Edragon/MCU-AVR-ATSAM/SAM-D10-Xplain-Mini_Design-Documentation/PCBA_rev2/BOM/Bill of Materials Print- SAM_D10_Xplained_Mini_release_rev2.xls

Sheet: Part List Report
 | Component list |  | ATSAMD10-XMINI
 | Source Data From: |  | ATSAMD10-XMINI.PrjPCB
 | Project: |  | ATSAMD10-XMINI.PrjPCB
 | Variant: |  | Default_assembly
 | Report Date: | 11/19/2014 | 3:48:48 PM
 | Print Date: | 11/19/2014 | 3:48:09 PM
# | Designator | Quantity | Value | Manufacturer | MPN | Description
1 | C101, C102, C104, C107, C108, C200, C201, C204, C205 | 9 | 100n | Kemet | C0402C104K4RACTU | Ceramic capacitor, SMD 0402, X7R, 16V, +/-10%
2 | C103 | 1 | 1u | Kemet | C0402C105K9PAC | Ceramic capacitor, SMD 0402, X5R, 6.3V, +/-10% (de26942)
3 | C105, C106 | 2 | 12pF | Kyocera-elco | CM05CG120J50AH | Ceramic capacitor, SMD 0402, NP0, 50V, +/-5% (de19819)
4 | C300, C302 | 2 | 4.7uF | AVX | 0603ZD475KAT2A | Ceramic capacitor, SMD 0603, X5R, 10V, ±10 %
5 | C301 | 1 | 10n |  |  | Ceramic capacitor, SMD 0402, X7R, 25V, +/-10%
6 | D100 | 1 | EL17-21SYGC | Everlight | EL17-21SYGC | LED, Green, Wave length=575nm, SMD 0805, ±70°
7 | D200 | 1 | EL17-21UYC/A3 | Everlight | 17-21UYC/S530-A3/TR8 | LED, Yellow, Wave length=591nm, SMD 0805, ±70°
8 | F100 | 1 | MC36213 | Multicomp | MC36213 | Resetable PTC fuse, Ih = 0.5A, It = 1.0A, 0805 package
9 | FW1 | 1 | MEDBG firmware |  |  | MEDBG firmware
10 | J101 | 1 | ZX62D-B-5PA8 | HIROSE | ZX62D-B-5PA8 | Micro USB B Connector, Standard SMT + DIP
11 | LABEL1 | 1 | PCBA Label | ACT Logimark AS | 505462 | PCBA identification label PP Top White Gloss
12 | PCB1 | 1 | ATSAMD10-XMINI PCB |  |  | ATSAMD10-XMINI PCB documantation
13 | PCBADOC1 | 1 | ATSAMD10-XMINI PCBA DOC |  |  | ATSAMD10-XMINI PCBA documantation
14 | Q101 | 1 | IRLML6402PBF | International Rectifier | IRLML6402PBF | P-ch. MOSFET. -30V, -3.7A continuous,RDS(ON)=0.05Ohm@VGS=-4,5V, RDS(ON)=0.08Ohm@VGS=-2.5V
15 | Q102 | 1 | 2N7002,215 | NXP | 2N7002,215 | N-Channel MOSFET. 60V, 0.300A continuous, 1.2A Peak. RDS(ON) = 3.8Ohm@VGS=4.5V, VGS(th)<2.5V
16 | R101, R102 | 2 | 22R | Samsung | RC100SF22R0CS | Thick film resistor, SMD 0402, 1/16W, 1% (de23607)
17 | R103 | 1 | 3.3k |  |  | Thick film resistor, SMD 0402, 1/16W, 1%
18 | R104, R105, R117, R118, R201, R203 | 6 | 100k |  |  | Thick film resistor, SMD 0402, 1/16W, 1%
19 | R107, R108, R202 | 3 | 1k |  |  | Thick film resistor, SMD 0402, 1/16W, 1%
20 | R109, R111, R112 | 3 | 330R |  |  | Thick film resistor, SMD 0402, 1/16W, 1%
21 | R110, R300, R302 | 3 | 0R | (n/a) | RMCF0402ZT0R00 | RES 0.0 OHM 1/16W 0402 SMD
22 | R114 | 1 | 680R |  |  | Thick film resistor, SMD 0402, 1/16W, 1%
23 | SW200 | 1 | SKRAAKE010 | ALPS | SKRAAKE010 | 6.2x6.2 mm SMD tact switch, same as A08-0091 but less force is needed
24 | TEST2 | 1 | Test SW for for A09-2376 |  |  | Test SW for for A09-2376, ATSAMD10-XMINI
25 | TESTDOC1 | 1 | ATmega168-XMINI Test Instructions |  |  | Fixture Test Instructions for ATmega168-XMINI
26 | U100 | 1 | ATmega32U4-MU | ATMEL | ATmega32U4-MU | ATmega32U4 QFN package
27 | U200 | 1 | ATSAMD10D14A-MUT | ATMEL | ATSAMD10D14A-MUT | Atmel 32-bit RISC MCU
28 | U300 | 1 | LP2985-33DBV | Texas Instruments | LP2985-33DBV | LDO 3.3V 150mA SOT23-5 1.5% (cer. cap)
29 | XC100 | 1 | 16.0MHz | Epson Toyocom | TSX-3225 16.0000MF09Z-AC3 | 16MHz uXtal, 3.2 x 2.5 mm SMD, CL=9pF, 15PPM, ESR=80ohm(Max.
 |  | 51
Approved |  |  | Notes

Sheet: Project Information
Project Full Path | D:\Tools Team\Xplained_Mini\SAMD10\18-Nov-2014\ATSAMD10-XMINI.PrjPCB
Project Filename | ATSAMD10-XMINI.PrjPCB
Variant Name | Default_assembly
Data-Source Filename | ATSAMD10-XMINI.PrjPCB
Data-Source Full Path | D:\Tools Team\Xplained_Mini\SAMD10\18-Nov-2014\ATSAMD10-XMINI.PrjPCB
Title | ATSAMD10-XMINI
Total Quantity | 51
Report Time | 3:48:48 PM
Report Date | 11/19/2014
Report Date & Tine | 11/19/2014 3:48:48 PM
Output Name | Bill of Materials Print
Output Type | BOM_PartType
Output Generator Name | BOM
Output Generator Description | Bill of Materials
