Edragon/MCU-AVR-ATSAM/SAM-D10-Xplain-Mini_Design-Documentation/PCBA_rev2/Test Points/Assembly Testpoint Report for SAM_D10_Xplained_Mini_release_rev2.txt

Net         Name        X Coord     Y Coord     Side        Hole Size   Type        
PA02        J203-1          6.35mm   20.3286mm  Bottom             1mm  Through hole
PA03        J203-2          6.35mm   17.7886mm  Bottom             1mm  Through hole
PA05        J203-4          6.35mm   12.7086mm  Bottom             1mm  Through hole
PA04        J203-3          6.35mm   15.2486mm  Bottom             1mm  Through hole
PA07        J203-6          6.35mm    7.6286mm  Bottom             1mm  Through hole
PA06        J203-5          6.35mm   10.1686mm  Bottom             1mm  Through hole
PA11        J201-1         54.61mm    7.6286mm  Bottom             1mm  Through hole
PA10        J201-2         54.61mm   10.1686mm  Bottom             1mm  Through hole
PA17        J201-4         54.61mm   15.2486mm  Bottom             1mm  Through hole
PA16        J201-3         54.61mm   12.7086mm  Bottom             1mm  Through hole
PA30        J201-7         54.61mm   22.8686mm  Bottom             1mm  Through hole
PA31        J201-8         54.61mm   25.4086mm  Bottom             1mm  Through hole
PA25        J201-6         54.61mm   20.3286mm  Bottom             1mm  Through hole
PA27        J201-5         54.61mm   17.7886mm  Bottom             1mm  Through hole
PA24        J200-5         54.61mm   39.6326mm  Bottom             1mm  Through hole
PA09        J200-6         54.61mm   42.1726mm  Bottom             1mm  Through hole
PA03        J200-8         54.61mm   47.2526mm  Bottom             1mm  Through hole
PA23        J200-3         54.61mm   34.5526mm  Bottom             1mm  Through hole
PA22        J200-4         54.61mm   37.0926mm  Bottom             1mm  Through hole
NetJ200_2   J200-2         54.61mm   32.0126mm  Bottom             1mm  Through hole
NetJ200_1   J200-1         54.61mm   29.4726mm  Bottom             1mm  Through hole
PA14        J200-9         54.61mm   49.7926mm  Bottom             1mm  Through hole
PA15        J200-10        54.61mm   52.3326mm  Bottom             1mm  Through hole
PD3_UART_TXD1J104-1         16.51mm   48.2686mm  Bottom             1mm  Through hole
PD2_UART_RXD1J104-2         16.51mm   50.8086mm  Bottom             1mm  Through hole
TDI         J100-9          50.8mm   56.5236mm  Bottom          0.65mm  Through hole
VCC_BOARD   J100-4         46.99mm   57.7936mm  Bottom          0.65mm  Through hole
S\R\S\T\    J100-6         48.26mm   57.7936mm  Bottom          0.65mm  Through hole
NetJ100_8   J100-8         49.53mm   57.7936mm  Bottom          0.65mm  Through hole
NetJ100_7   J100-7         49.53mm   56.5236mm  Bottom          0.65mm  Through hole
TMS         J100-5         48.26mm   56.5236mm  Bottom          0.65mm  Through hole
TDO         J100-3         46.99mm   56.5236mm  Bottom          0.65mm  Through hole
TCK         J100-1         45.72mm   56.5236mm  Bottom          0.65mm  Through hole
VCC_TARGET  J204-2         34.24mm    4.9486mm  Bottom             1mm  Through hole
PA22        J204-4          31.7mm    4.9486mm  Bottom             1mm  Through hole
PA24        J204-1         34.24mm    7.4886mm  Bottom             1mm  Through hole
PA09        J204-3          31.7mm    7.4886mm  Bottom             1mm  Through hole
PA28        J204-5         29.16mm    7.4886mm  Bottom             1mm  Through hole
NetJ202_1   J202-1          6.35mm   43.1886mm  Bottom             1mm  Through hole
VCC_TARGET  J202-2          6.35mm   40.6486mm  Bottom             1mm  Through hole
VCC_P3V3    J202-4          6.35mm   35.5686mm  Bottom             1mm  Through hole
RESET_SENSE J202-3          6.35mm   38.1086mm  Bottom             1mm  Through hole
GND         J202-7          6.35mm   27.9486mm  Bottom             1mm  Through hole
VCC_VIN     J202-8          6.35mm   25.4086mm  Bottom             1mm  Through hole
VCC_P5V0    Free-0          3.81mm   33.0286mm  Bottom             1mm  Through hole
            Free-5         16.51mm   25.4086mm  Bottom             1mm  Through hole
            Free-5         16.51mm   22.8686mm  Bottom             1mm  Through hole
GND         Via            29.65mm   67.3386mm  Bottom          0.25mm  Through hole
NetD100_1   Via           29.275mm   35.4543mm  Bottom          0.25mm  Through hole
VCC_VBUS    Via            34.35mm   67.2836mm  Bottom          0.25mm  Through hole
USBD_P      Via            29.65mm   68.6086mm  Bottom          0.25mm  Through hole
USBD_N      Via               31mm   68.6086mm  Bottom          0.25mm  Through hole
POWER_ENABLEVia          27.8775mm   38.8336mm  Bottom          0.25mm  Through hole
NetU100_8   Via          27.6477mm   52.1754mm  Bottom          0.25mm  Through hole
NetU100_12  Via           26.075mm   49.6483mm  Bottom          0.25mm  Through hole
TARGET_RESETVia             28.7mm   42.2086mm  Bottom          0.25mm  Through hole
NetU100_18  Via          24.9262mm   46.0359mm  Bottom          0.25mm  Through hole
NetU100_22  Via            25.85mm   43.1336mm  Bottom          0.25mm  Through hole
NetU100_19  Via           23.975mm   42.8836mm  Bottom          0.25mm  Through hole
NetJ102_2   Via          34.3814mm   41.0533mm  Bottom          0.25mm  Through hole
EXT_CLK     Via            29.85mm   41.5086mm  Bottom          0.25mm  Through hole
