Edragon/MCU-AVR-ATSAM/SAM-D10-Xplain-Mini_Design-Documentation/PCBA_rev2/SAM_D10_Xplained_Mini_layer_plots_release_rev2.pdf

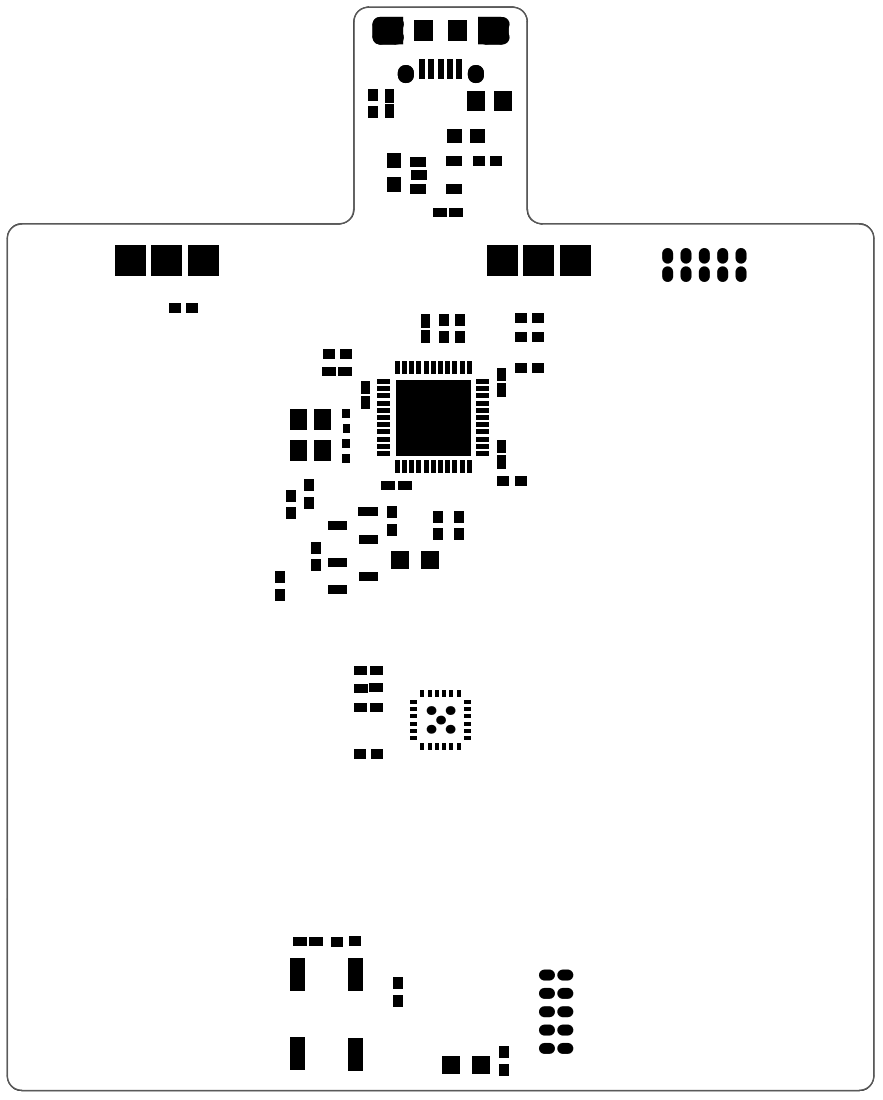
[picture p14: page 1]

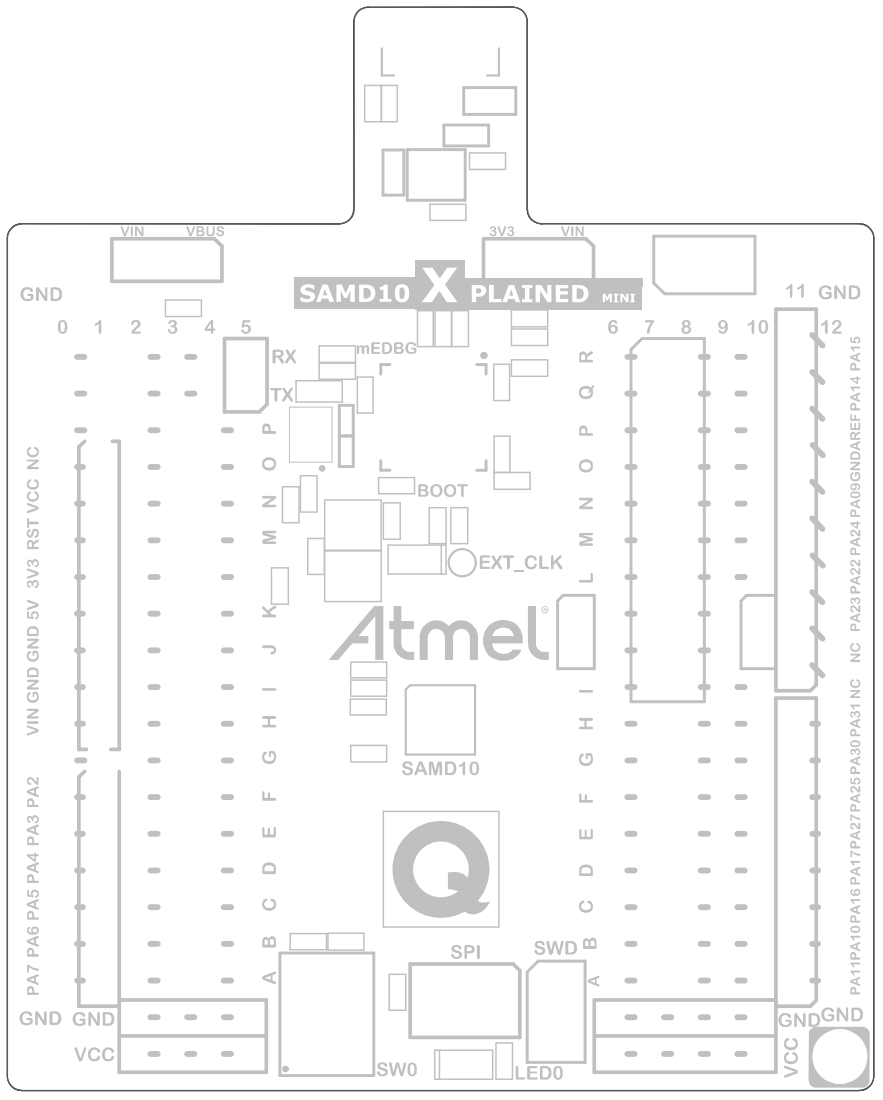
[picture p15: page 2]

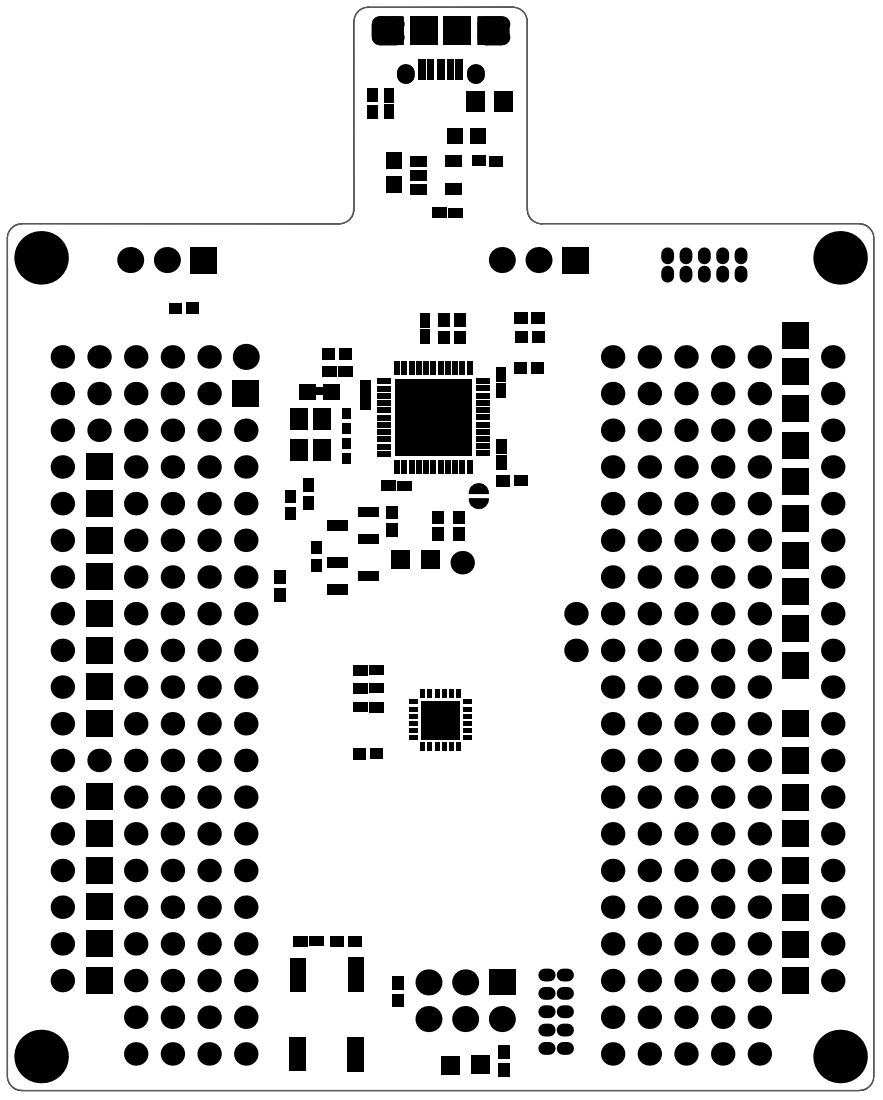
[picture p16: page 3]

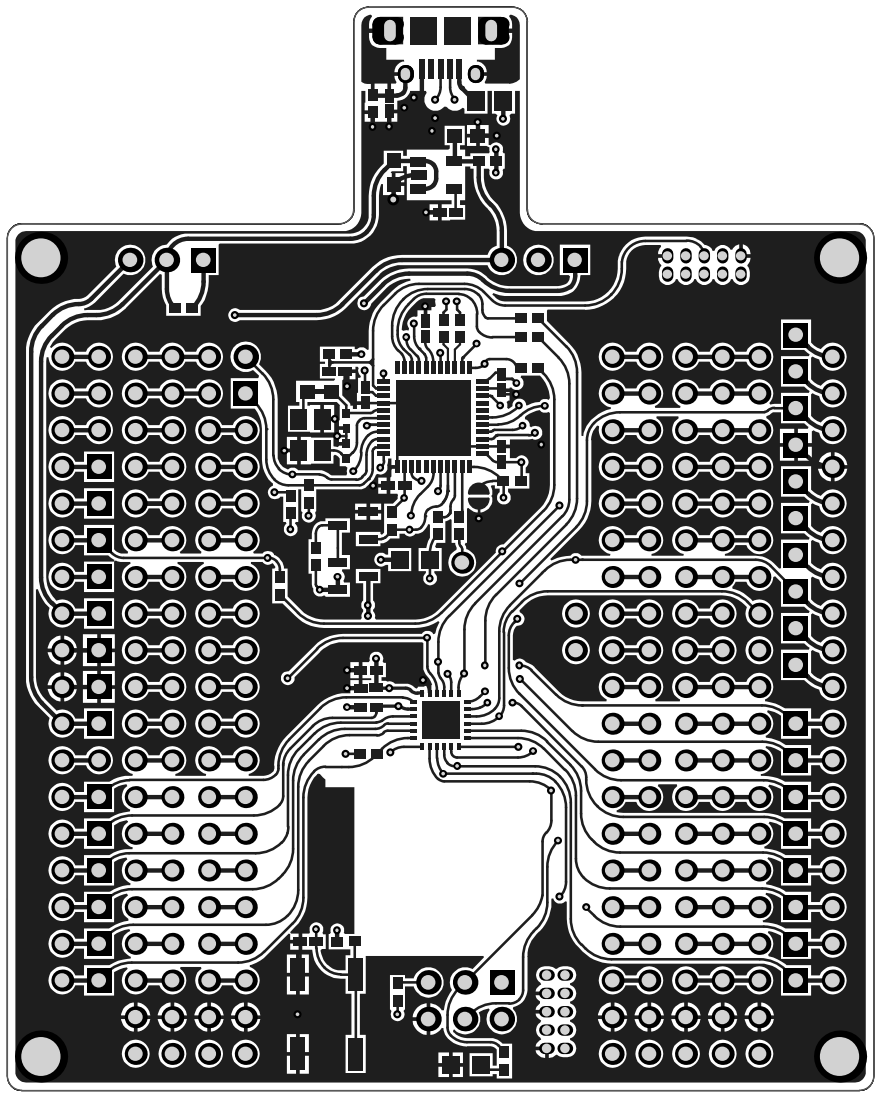
[picture p17: page 4]

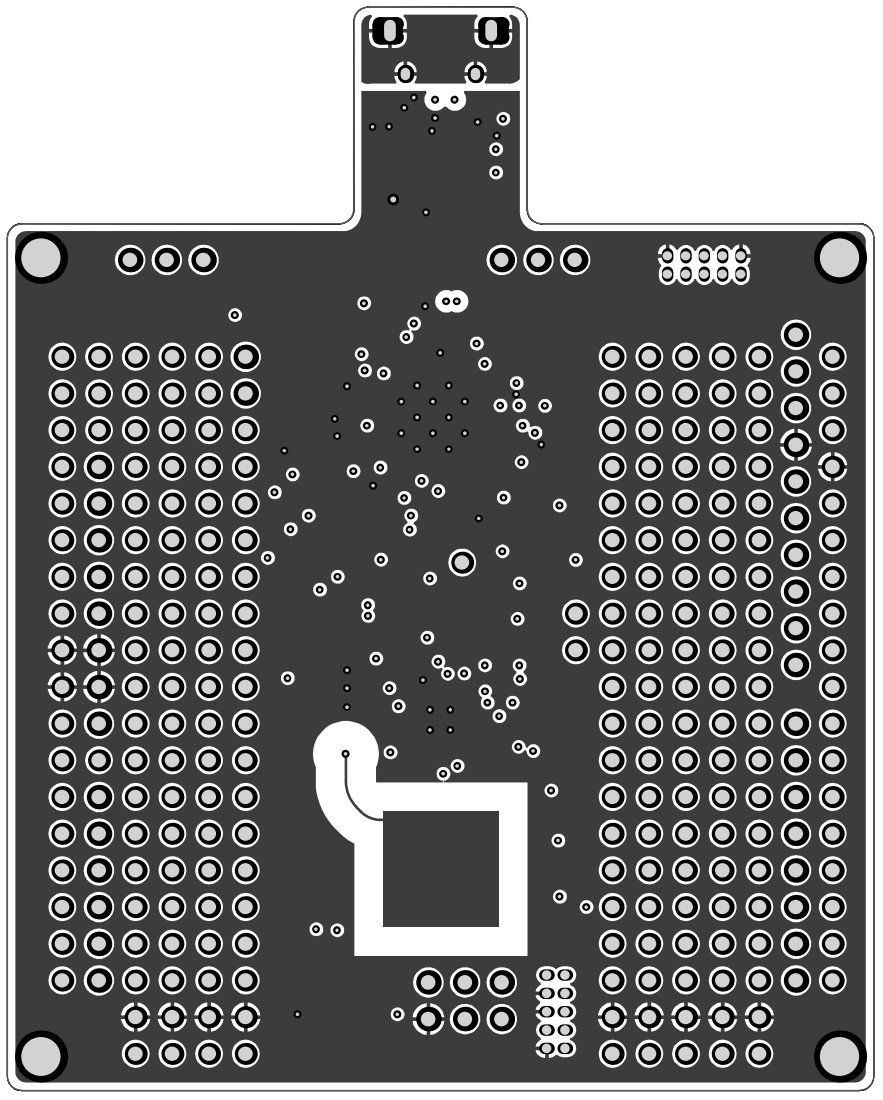
[picture p18: page 5]

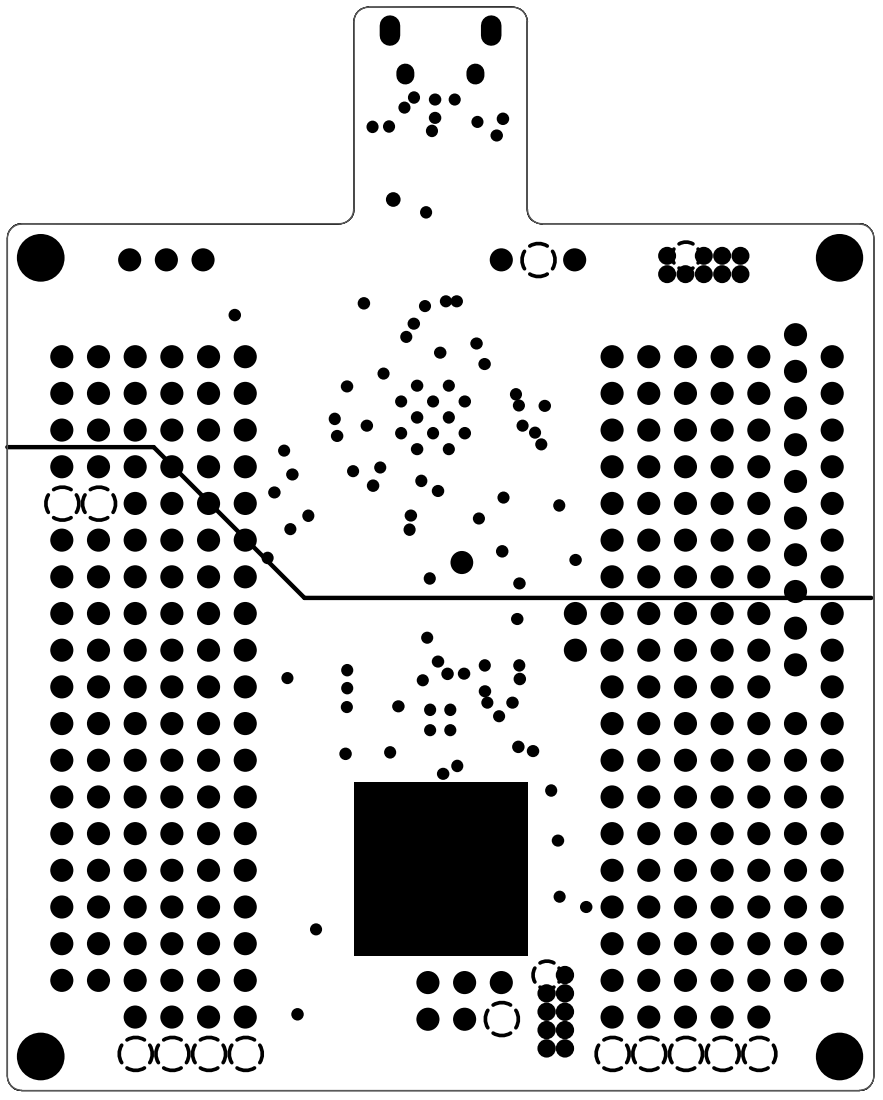
[picture p19: page 6]

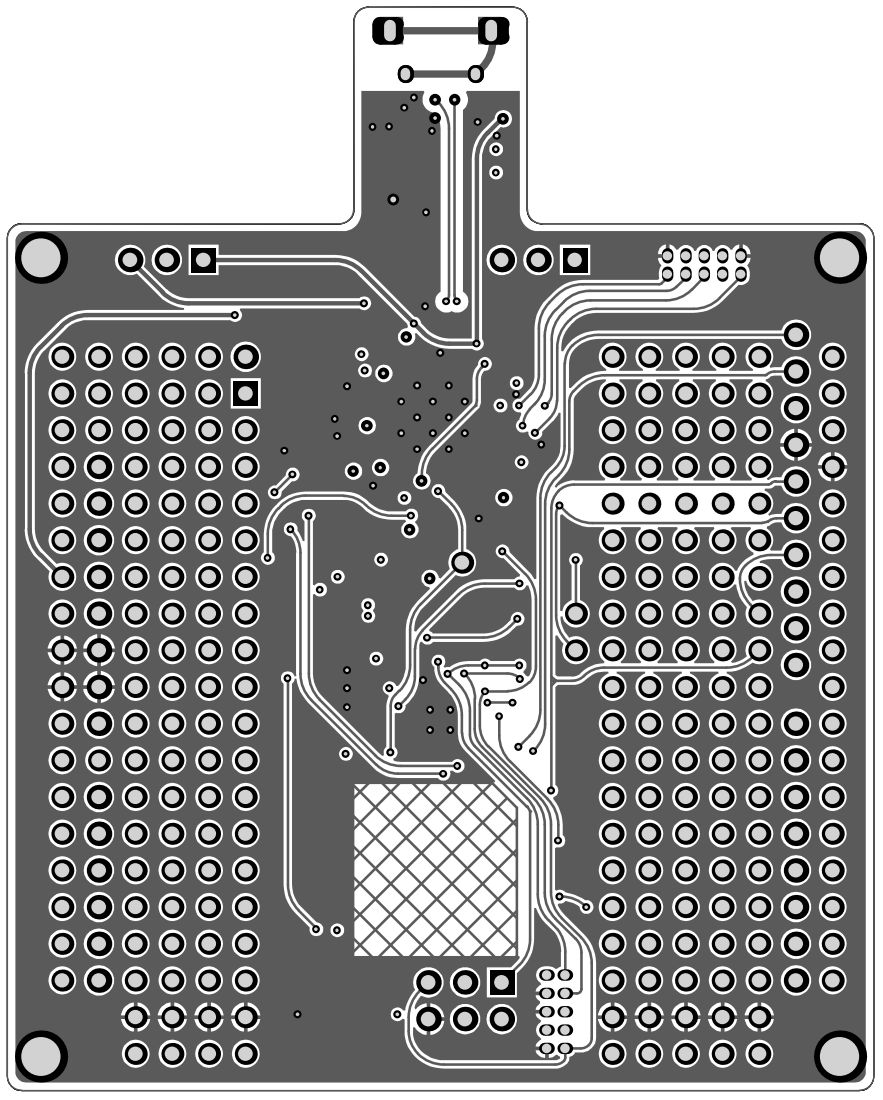
[picture p20: page 7]

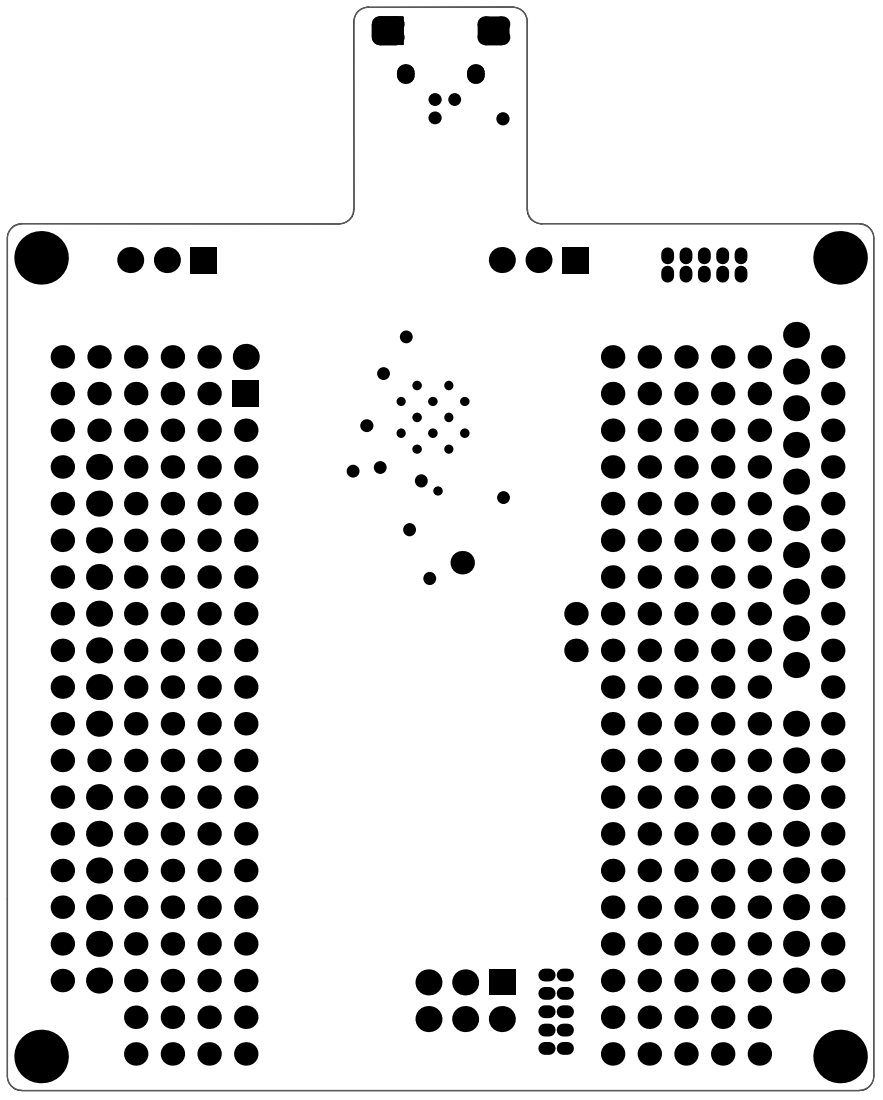
[picture p21: page 8]

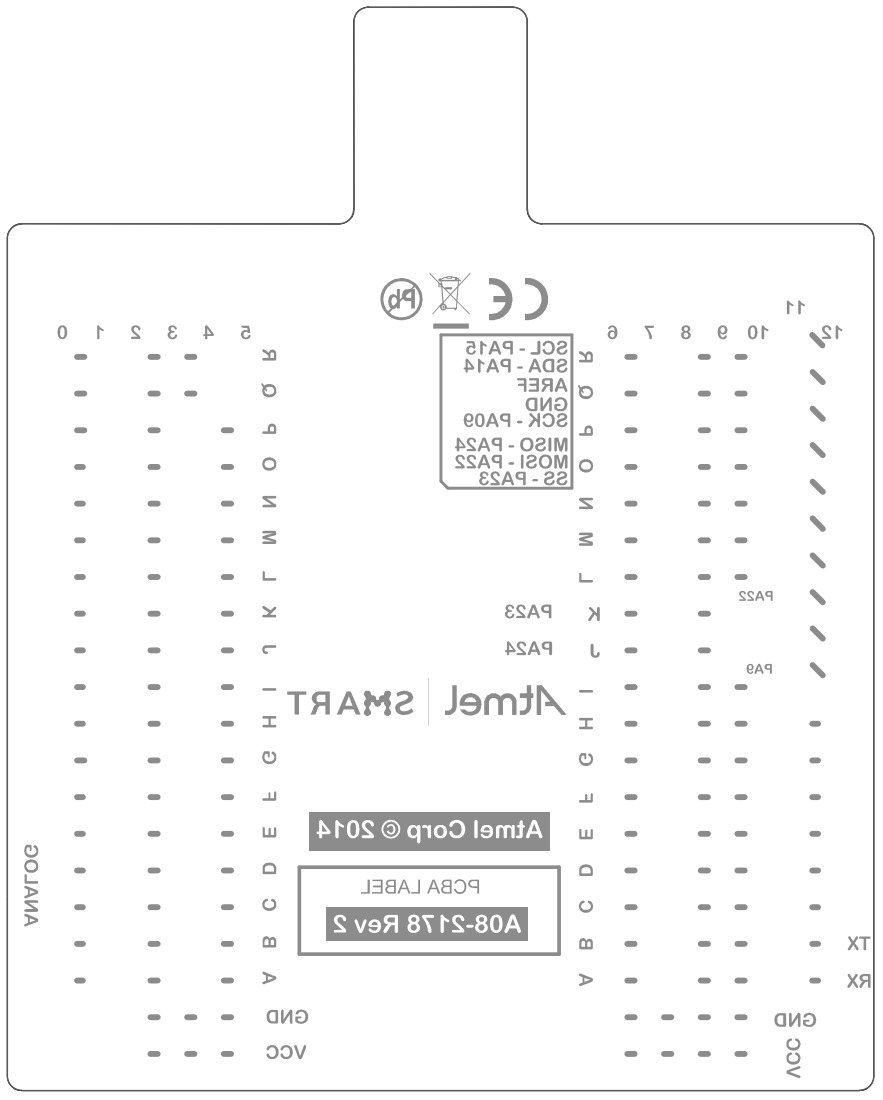
[picture p22: page 9]

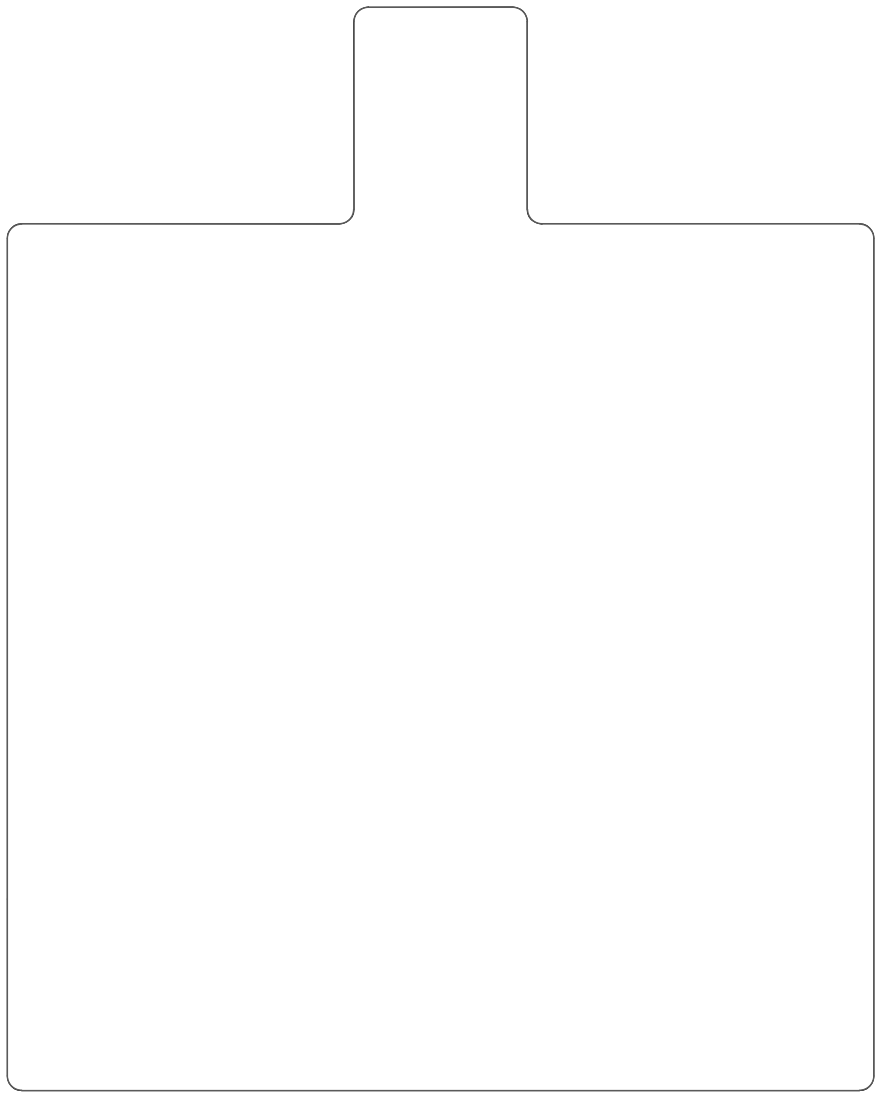
[picture p23: page 10]
