Edragon/MCU-AVR-ATSAM/(list of files, drawings)

Other design files:
SAM-D10-Xplain-Mini_Design-Documentation/PCBA_rev2/SAM_D10_Xplained_Mini_CAD_source_PCBA_rev2/ATSAMD10-XMINI.PrjPCB
SAM-D10-Xplain-Mini_Design-Documentation/PCBA_rev2/SAM_D10_Xplained_Mini_CAD_source_PCBA_rev2/ATSAMD10-XMINI_Programmer.SchDoc
SAM-D10-Xplain-Mini_Design-Documentation/PCBA_rev2/SAM_D10_Xplained_Mini_CAD_source_PCBA_rev2/ATSAMD10-XMINI_Target.SchDoc
SAM-D10-Xplain-Mini_Design-Documentation/PCBA_rev2/SAM_D10_Xplained_Mini_CAD_source_PCBA_rev2/ATSAMD10-XMINI_TopLevel.SchDoc
